sonny-heera/bird-feeder-project/(list of files, drawings)

Other design files:
receiver.dip
remote.dip
